natehouk/AS3310-ADSR/README.md

# SS-ADSR-1
Envelope generator based on the AS3310-ADSR.
