natehouk/AS3310-ADSR/SS-ADSR-1_BOM.xlsx

Front/Back | Manufacture | Part # | URL | Component | Description | Part | References | Value | Footprint | Quantity Per PCB | Datasheet | Field4 | Field5 | Field6
Front | ‎Vishay Beyschlag/Draloric/BC Components | ‎K103K15X7RF5TL2 | https://www.digikey.com/product-detail/en/vishay-beyschlag-draloric-bc-components/K103K15X7RF5TL2/BC1078CT-ND/286700 | 1 | Unpolarized capacitor | C | C2 C4 C5 C7 | 10nF | C_Disc_D7.5mm_W2.5mm_P5.00mm | 4 | ~
Front | NTE Electronics, Inc‎ | ‎89322 | https://www.digikey.com/product-detail/en/nte-electronics-inc/89322/2368-89322-ND/11647987 | 2 | Unpolarized capacitor | C | C1 | 22nF | C_Disc_D7.5mm_W2.5mm_P5.00mm | 1 | ~
Front | ‎Vishay Beyschlag/Draloric/BC Components | ‎K333K15X7RF5TL2 | https://www.digikey.com/product-detail/en/vishay-beyschlag-draloric-bc-components/K333K15X7RF5TL2/BC1081CT-ND/286703 | 3 | Unpolarized capacitor | C | C6 | 33nF | C_Disc_D7.5mm_W2.5mm_P5.00mm | 1 | ~
Front | ‎KEMET‎ | ‎C322C393K1R5TA | https://www.digikey.com/product-detail/en/kemet/C322C393K1R5TA/399-13949-ND/6562360 | 4 | Unpolarized capacitor | C | C3 | 39nF | C_Disc_D7.5mm_W2.5mm_P5.00mm | 1 | ~
Front | Vishay Beyschlag/Draloric/BC Components | K104Z15Y5VE5TL2 | https://www.digikey.com/en/products/detail/w%C3%BCrth-elektronik/860020572003/5728880 | 5 | Unpolarized capacitor | C | C8 C11 | .1uF | C_Disc_D7.5mm_W2.5mm_P5.00mm | 2 | ~
Front | Würth Elektronik‎ | 860020572003 | https://www.digikey.com/en/products/detail/w%C3%BCrth-elektronik/860020572003/5728880 | 6 | Polarized capacitor | C | C9 C10 | 10uF | C_Disc_D7.5mm_W2.5mm_P5.00mm | 2 | ~
Front | ‎NTE Electronics, Inc‎ | ‎1N4148 | https://www.digikey.com/product-detail/en/nte-electronics-inc/1N4148/2368-1N4148-ND/11645052 | 7 | Diode | D | D1 D2 | D | D_DO-35_SOD27_P7.62mm_Horizontal | 2 | ~
Back | Würth Elektronik‎ | ‎151051RS11000‎ | https://www.digikey.com/product-detail/en/w-rth-elektronik/151051RS11000/732-5016-ND/4490012 | 8 | Light emitting diode | LED | D3 | LED | LED_D5.0mm | 1 | ~
Front | ‎Würth Elektronik‎ | ‎61201021621‎ | https://www.digikey.com/product-detail/en/w-rth-elektronik/61201021621/732-2094-ND/2060590 | 9 |  | EURO_PWR_2x5 | J2 | EURO_PWR_2x5 | PinHeader_2x05_P2.54mm_Vertical | 1
Back | Thonkiconn | PJ398SM | https://nl.mouser.com/ProductDetail/Alpha-Taiwan/RD901F-40-15R1-B100K-00DL1?qs=1mbolxNpo8czbLgndpJJVQ%3D%3D | 10 | Audio Jack, 2 Poles (Mono / TS), Switched T Pole (Normalling) | AudioJack2_SwitchT | J1 J3 J4 | TRIGGER_IN | Jack_3.5mm_QingPu_WQP-PJ398SM_Vertical_CircularHoles | 3 | ~
Front | ON Semiconductor‎ | ‎BC548BU | https://www.digikey.com/product-detail/en/on-semiconductor/BC548BU/BC548BU-ND/976761 | 11 | 0.1A Ic, 30V Vce, Small Signal NPN Transistor, TO-92 | BC548 | Q2 | BC548 | TO-92_Inline | 1 | https://www.onsemi.com/pub/Collateral/BC550-D.pdf
Front | ‎NTE Electronics, Inc‎ | BC558‎ | https://www.digikey.com/product-detail/en/nte-electronics-inc/BC558/2368-BC558-ND/11652250 | 12 | 0.1A Ic, 30V Vce, PNP Small Signal Transistor, TO-92 | BC558 | Q1 | BC558 | TO-92_Inline | 1 | https://www.onsemi.com/pub/Collateral/BC556BTA-D.pdf
Front | Vishay Beyschlag/Draloric/BC Components‎ | ‎SFR25H0003300FR500 | https://www.digikey.com/product-detail/en/vishay-beyschlag-draloric-bc-components/SFR25H0003300FR500/56-SFR25H0003300FR500CT-ND/11507983 | 13 | Resistor | R | R26 | 330R | R_Axial_DIN0207_L6.3mm_D2.5mm_P10.16mm_Horizontal | 1 | ~
Front | Vishay Beyschlag/Draloric/BC Components‎ | ‎SFR2500004700FR500 | https://www.digikey.com/product-detail/en/vishay-beyschlag-draloric-bc-components/SFR2500004700FR500/56-SFR2500004700FR500CT-ND/11508187 | 14 | Resistor | R | R12 | 470R | R_Axial_DIN0207_L6.3mm_D2.5mm_P10.16mm_Horizontal | 1 | ~
Front | Vishay Beyschlag/Draloric/BC Components | SFR25H0001001FR500 | https://www.digikey.com/en/products/detail/vishay-beyschlag-draloric-bc-components/SFR25H0001001FR500/5065693 | 15 | Resistor | R | R5 R6 R7 R22 | 1K | R_Axial_DIN0207_L6.3mm_D2.5mm_P10.16mm_Horizontal | 4 | ~
Front | Vishay Beyschlag/Draloric/BC Components‎ | ‎SFR2500004701FR500 | https://www.digikey.com/product-detail/en/vishay-beyschlag-draloric-bc-components/SFR2500004701FR500/BC4373TR-ND/333920 | 16 | Resistor | R | R15 R23 R25 | 4K7 | R_Axial_DIN0207_L6.3mm_D2.5mm_P10.16mm_Horizontal | 3 | ~
Front | Vishay Beyschlag/Draloric/BC Components | SFR2500001002FR500 | https://www.digikey.com/en/products/detail/vishay-beyschlag-draloric-bc-components/SFR2500001002FR500/595641 | 17 | Resistor | R | R9 R16 R17 R18 R21 | 10K | R_Axial_DIN0207_L6.3mm_D2.5mm_P10.16mm_Horizontal | 5 | ~
Front | Vishay Beyschlag/Draloric/BC Components‎ | ‎SFR2500002202FR500‎ | https://www.digikey.com/product-detail/en/vishay-beyschlag-draloric-bc-components/SFR2500002202FR500/56-SFR2500002202FR500CT-ND/11508107 | 18 | Resistor | R | R11 R14 | 22K | R_Axial_DIN0207_L6.3mm_D2.5mm_P10.16mm_Horizontal | 2 | ~
Front | Vishay Beyschlag/Draloric/BC Components‎ | ‎SFR2500003602FR500‎ | https://www.digikey.com/product-detail/en/vishay-beyschlag-draloric-bc-components/SFR2500003602FR500/PPC36.0KYCT-ND/597028 | 19 | Resistor | R | R13 | 36K | R_Axial_DIN0207_L6.3mm_D2.5mm_P10.16mm_Horizontal | 1 | ~
Front | Vishay Beyschlag/Draloric/BC Components‎ | ‎SFR2500003902FR500 | https://www.digikey.com/product-detail/en/vishay-beyschlag-draloric-bc-components/SFR2500003902FR500/56-SFR2500003902FR500CT-ND/11508028 | 20 | Resistor | R | R8 | 39K | R_Axial_DIN0207_L6.3mm_D2.5mm_P10.16mm_Horizontal | 1 | ~
Front | Vishay Beyschlag/Draloric/BC Components‎ | ‎SFR2500004702FR500‎ | https://www.digikey.com/product-detail/en/vishay-beyschlag-draloric-bc-components/SFR2500004702FR500/56-SFR2500004702FR500CT-ND/11508192 | 21 | Resistor | R | R19 | 47K | R_Axial_DIN0207_L6.3mm_D2.5mm_P10.16mm_Horizontal | 1 | ~
Front | Vishay Beyschlag/Draloric/BC Components‎ | ‎MRS25000C6202FCT00 | https://www.digikey.com/product-detail/en/vishay-beyschlag-draloric-bc-components/MRS25000C6202FCT00/BC4647CT-ND/7352077 | 22 | Resistor | R | R1 R2 R3 | 62K | R_Axial_DIN0207_L6.3mm_D2.5mm_P10.16mm_Horizontal | 3 | ~
Front | Vishay Beyschlag/Draloric/BC Components | SFR16S0001003FR500 | https://www.digikey.com/en/products/detail/vishay-beyschlag-draloric-bc-components/SFR16S0001003FR500/594266 | 23 | Resistor | R | R24 | 100K | R_Axial_DIN0207_L6.3mm_D2.5mm_P10.16mm_Horizontal | 1 | ~
Front | Vishay Beyschlag/Draloric/BC Components‎ | ‎SFR2500001503FR500 | https://www.digikey.com/product-detail/en/vishay-beyschlag-draloric-bc-components/SFR2500001503FR500/PPC150KYCT-ND/596882 | 24 | Resistor | R | R20 | 150K | R_Axial_DIN0207_L6.3mm_D2.5mm_P10.16mm_Horizontal | 1 | ~
Front | Vishay Beyschlag/Draloric/BC Components‎ | ‎SFR2500004703FR500 | https://www.digikey.com/product-detail/en/vishay-beyschlag-draloric-bc-components/SFR2500004703FR500/BC4377CT-ND/7351807 | 25 | Resistor | R | R4 | 470K | R_Axial_DIN0207_L6.3mm_D2.5mm_P10.16mm_Horizontal | 1 | ~
Front | Vishay Beyschlag/Draloric/BC Components | SFR2500001004FR500 | https://www.digikey.com/en/products/detail/vishay-beyschlag-draloric-bc-components/SFR2500001004FR500/595723 | 26 | Resistor | R | R10 | 1M | R_Axial_DIN0207_L6.3mm_D2.5mm_P10.16mm_Horizontal | 1 | ~
Front | ‎Bourns Inc.‎ | ‎3266Y-1-103LF‎ | https://www.digikey.com/product-detail/en/bourns-inc/3266Y-1-103LF/3266Y-1-103LF-ND/2535458 | 27 | Trim-potentiometer | R_Potentiometer_Trim | RV5 RV6 | 10K | Potentiometer_Runtron_RM-065_Vertical | 2 | ~
Front | ‎TT Electronics/BI‎ | ‎P0915N-FC15BR50K‎ | https://www.digikey.com/product-detail/en/tt-electronics-bi/P0915N-FC15BR50K/P0915N-FC15BR50K-ND/7720803 | 28 | Potentiometer | R_Potentiometer | RV1 RV2 RV3 RV4 | 47K lin | Potentiometer_Alpha_RD901F-40-00D_Single_Vertical | 4 | ~
Back | ‎NKK Switches‎ | ‎M2044SS1W03 | https://www.digikey.com/product-detail/en/nkk-switches/M2044SS1W03/360-2865-ND/1027467 | 29 |  | M2044SS1W03 | S1 | M2044SS1W03 | SW_M2044SS1W03 | 1 | 30.9 mm | NKK Switches | 2018-05-09 | Manufacturer Recommendations
Back | E-Switch‎ | ‎PS1024ALRED | https://www.digikey.com/product-detail/en/e-switch/PS1024ALRED/EG2025-ND/81539 | 30 | Push button switch, generic, two pins | SW_Push | SW2 | SW_Push | SW_PUSH_6mm_H5mm | 1 | ~
Front | ‎Amphenol ICC (FCI)‎ | ‎DILB16P-223TLF‎ | https://www.digikey.com/product-detail/en/amphenol-icc-fci/DILB16P-223TLF/609-4713-ND/4292068 | 31 | ADSR Voltage Controlled Envelope Generator, DIP-16/SOIC-16 | AS3310 | U2 | AS3310 | DIP-16_W7.62mm | 1 | http://www.alfarzpp.lv/eng/sc/AS3310.pdf
Front | Texas Instruments‎ | ‎LM358P | https://www.digikey.com/product-detail/en/texas-instruments/LM358P/296-1395-5-ND/277042 | 32 | Low-Power, Dual Operational Amplifiers, DIP-8/SOIC-8/TO-99-8 | LM358 | U1 U3 | LM358 | DIP-8_W7.62mm | 2 | http://www.ti.com/lit/ds/symlink/lm2904-n.pdf
Front | Texas Instruments‎ | ‎LM741CN/NOPB | https://www.digikey.com/product-detail/en/texas-instruments/LM741CN-NOPB/LM741CNNS-NOPB-ND/6322 | 33 | Operational Amplifier, DIP-8/TO-99-8 | LM741 | U4 | LM741 | DIP-8_W7.62mm | 1 | http://www.ti.com/lit/ds/symlink/lm741.pdf
 | Thonk.co.uk
 | Digikey.com
 |  |  |  | Component Groups: | 33
 |  |  |  | Component Count: | 58
 |  |  |  | Fitted Components: | 58
 |  |  |  | Number of PCBs: | 1
 |  |  |  | Total components: | 58
 |  |  |  | Schematic Version: | 1
 |  |  |  | Schematic Date: | 2020-11-01
 |  |  |  | PCB Variant: | default
 |  |  |  | BoM Date: | Sun 08 Nov 2020 06:55:45 PM CET
 |  |  |  | Schematic Source: | AS3310-ADSR.sch
 |  |  |  | KiCad Version: | Eeschema 5.1.7
