natehouk/AS3310-ADSR/(list of files, drawings)

Other design files:
AS3310-ADSR.dsn
