natehouk/AS3310-ADSR/AS3310-ADSR.kicad_pcb

## KiCad design AS3310-ADSR.kicad_pcb (2020-12-31)

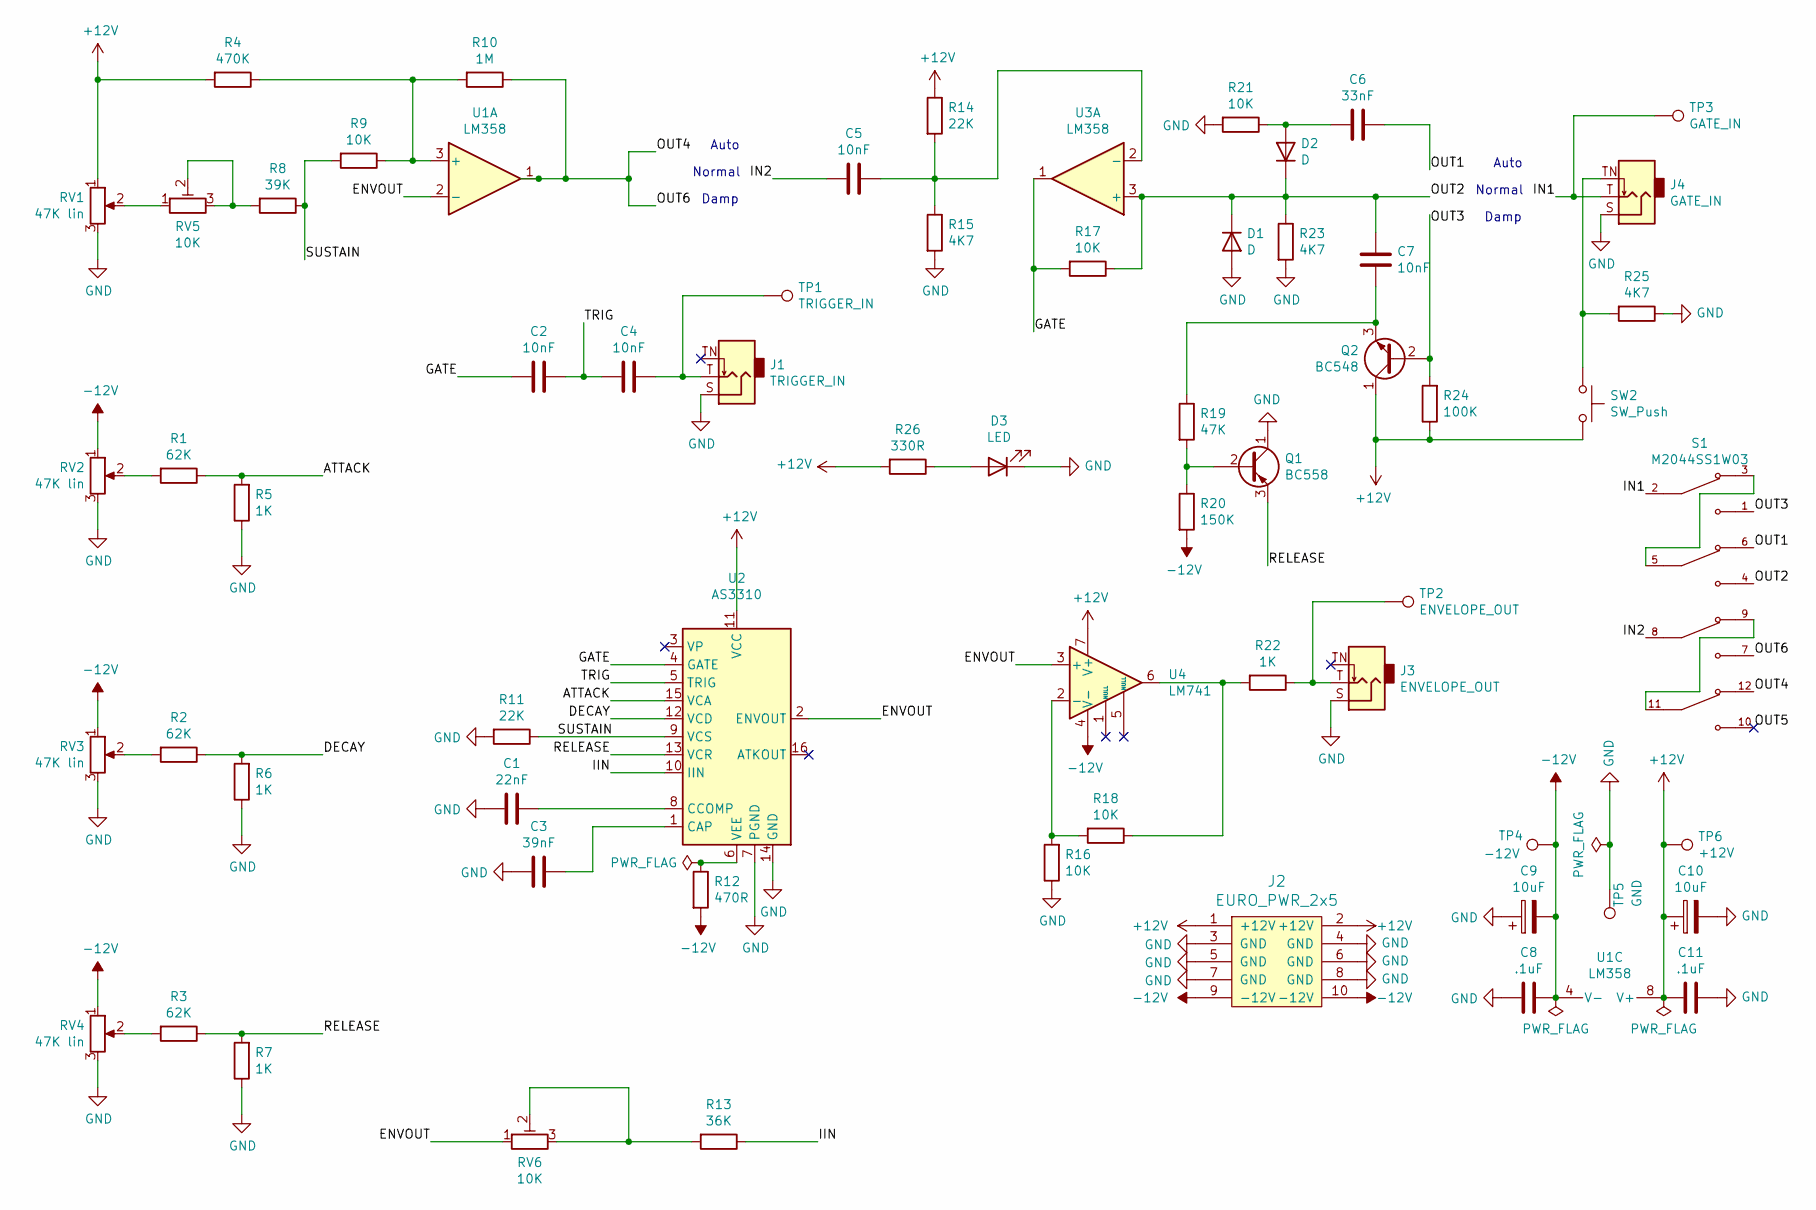
[picture p1: schematic AS3310-ADSR.sch, SS-ADSR-1]

Parts:
C1: 22nF; C_Disc_D7.5mm_W2.5mm_P5.00mm
C2, C4, C5, C7: 10nF; C_Disc_D7.5mm_W2.5mm_P5.00mm
C3: 39nF; C_Disc_D7.5mm_W2.5mm_P5.00mm
C6: 33nF; C_Disc_D7.5mm_W2.5mm_P5.00mm
C8, C11: .1uF; C_Disc_D7.5mm_W2.5mm_P5.00mm
C9, C10: 10uF; CP_Radial_D5.0mm_P2.50mm
D1, D2: D; D_DO-35_SOD27_P7.62mm_Horizontal
D3: LED; LED_D5.0mm
J1: TRIGGER_IN; Jack_3.5mm_QingPu_WQP-PJ398SM_Vertical_CircularHoles
J2: EURO_PWR_2x5; PinHeader_2x05_P2.54mm_Vertical
J3: ENVELOPE_OUT; Jack_3.5mm_QingPu_WQP-PJ398SM_Vertical_CircularHoles
J4: GATE_IN; Jack_3.5mm_QingPu_WQP-PJ398SM_Vertical_CircularHoles
Q1: BC558; TO-92_Inline
Q2: BC548; TO-92_Inline
R1, R2, R3: 62K; R_Axial_DIN0207_L6.3mm_D2.5mm_P10.16mm_Horizontal
R4: 470K; R_Axial_DIN0207_L6.3mm_D2.5mm_P10.16mm_Horizontal
R5, R6, R7, R22: 1K; R_Axial_DIN0207_L6.3mm_D2.5mm_P10.16mm_Horizontal
R8: 39K; R_Axial_DIN0207_L6.3mm_D2.5mm_P10.16mm_Horizontal
R9, R16, R17, R18, R21: 10K; R_Axial_DIN0207_L6.3mm_D2.5mm_P10.16mm_Horizontal
R10: 1M; R_Axial_DIN0207_L6.3mm_D2.5mm_P10.16mm_Horizontal
R11, R14: 22K; R_Axial_DIN0207_L6.3mm_D2.5mm_P10.16mm_Horizontal
R12: 470R; R_Axial_DIN0207_L6.3mm_D2.5mm_P10.16mm_Horizontal
R13: 36K; R_Axial_DIN0207_L6.3mm_D2.5mm_P10.16mm_Horizontal
R15, R23, R25: 4K7; R_Axial_DIN0207_L6.3mm_D2.5mm_P10.16mm_Horizontal
R19: 47K; R_Axial_DIN0207_L6.3mm_D2.5mm_P10.16mm_Horizontal
R20: 150K; R_Axial_DIN0207_L6.3mm_D2.5mm_P10.16mm_Horizontal
R24: 100K; R_Axial_DIN0207_L6.3mm_D2.5mm_P10.16mm_Horizontal
R26: 330R; R_Axial_DIN0207_L6.3mm_D2.5mm_P10.16mm_Horizontal
RV1, RV2, RV3, RV4: 47K lin; Potentiometer_Alpha_RD901F-40-00D_Single_Vertical
RV5, RV6: 10K; TRIM_3266W-1-102LF
S1: M2044SS1W03; SW_M2044SS1W03
SW2: SW_Push; SW_PS1024ALRED
TP1: TRIGGER_IN; TestPoint_Pad_4.0x4.0mm
TP2: ENVELOPE_OUT; TestPoint_Pad_4.0x4.0mm
TP3: GATE_IN; TestPoint_Pad_4.0x4.0mm
TP4: -12V; TestPoint_Pad_4.0x4.0mm
TP5: GND; TestPoint_Pad_4.0x4.0mm
TP6: +12V; TestPoint_Pad_4.0x4.0mm
U1, U3: LM358; DIP-8_W7.62mm
U2: AS3310; DIP-16_W7.62mm
U4: LM741; DIP-8_W7.62mm

Connections:
+12V: C10.1, C11.2, J2.1 (+12V), J2.2 (+12V), Q2.1 (C), R4.2, R14.1, R24.1, R26.2, RV1.1, SW2.2, TP6.1, U1.8 (V+), U2.11 (VCC), U4.7 (V+)
-12V: C8.1, C9.2, J2.9 (-12V), J2.10 (-12V), R12.2, R20.2, RV2.1, RV3.1, RV4.1, TP4.1, U1.4 (V-), U4.4 (V-)
/ATTACK: R1.1, R5.2, U2.15 (VCA)
/DECAY: R2.1, R6.2, U2.12 (VCD)
/ENVOUT: RV6.1, U1.2 (-), U2.2 (ENVOUT), U4.3 (+)
/GATE: C2.2, R17.2, U2.4 (GATE), U3.1
/IIN: R13.1, U2.10 (IIN)
/IN1: J4.T, S1.2, TP3.1
/IN2: C5.2, S1.8
/OUT1: C6.1, S1.6
/OUT2: C7.1, D1.1 (K), D2.1 (K), R17.1, R23.1, S1.4, U3.3 (+)
/OUT3: Q2.2 (B), R24.2, S1.1
/OUT4: R10.1, S1.7, S1.12, U1.1
/RELEASE: Q1.3 (E), R3.1, R7.2, U2.13 (VCR)
/SUSTAIN: R8.1, R9.2, R11.1, U2.9 (VCS)
/TRIG: C2.1, C4.2, U2.5 (TRIG)
GND: C1.2, C3.2, C8.2, C9.1, C10.2, C11.1, D1.2 (A), D3.1 (K), J1.S, J2.3 (GND), J2.4 (GND), J2.5 (GND), J2.6 (GND), J2.7 (GND), J2.8 (GND), J3.S, J4.S, Q1.1 (C), R5.1, R6.1, R7.1, R11.2, R15.2, R16.1, R21.2, R23.2, R25.1, RV1.3, RV2.3, RV3.3, RV4.3, TP5.1, U2.7 (PGND), U2.14 (GND)
unnamed: C1.1, U2.8 (CCOMP)
unnamed: C3.1, U2.1 (CAP)
unnamed: C4.1, J1.T, TP1.1
unnamed: C5.1, R14.2, R15.1, U3.2 (-)
unnamed: C6.2, D2.2 (A), R21.1
unnamed: C7.2, Q2.3 (E), R19.1
unnamed: D3.2 (A), R26.1
unnamed: J3.T, R22.1, TP2.1
unnamed: J4.TN, R25.2, SW2.1
unnamed: Q1.2 (B), R19.2, R20.1
unnamed: R1.2, RV2.2
unnamed: R2.2, RV3.2
unnamed: R3.2, RV4.2
unnamed: R8.2, RV5.2, RV5.3
unnamed: R4.1, R9.1, R10.2, U1.3 (+)
unnamed: R12.1, U2.6 (VEE)
unnamed: R13.2, RV6.2, RV6.3
unnamed: R16.2, R18.2, U4.2 (-)
unnamed: R18.1, R22.2, U4.6
unnamed: RV1.2, RV5.1
unnamed: S1.3, S1.5
unnamed: S1.9, S1.11

Notes on the sheet:
Auto
Normal
Damp

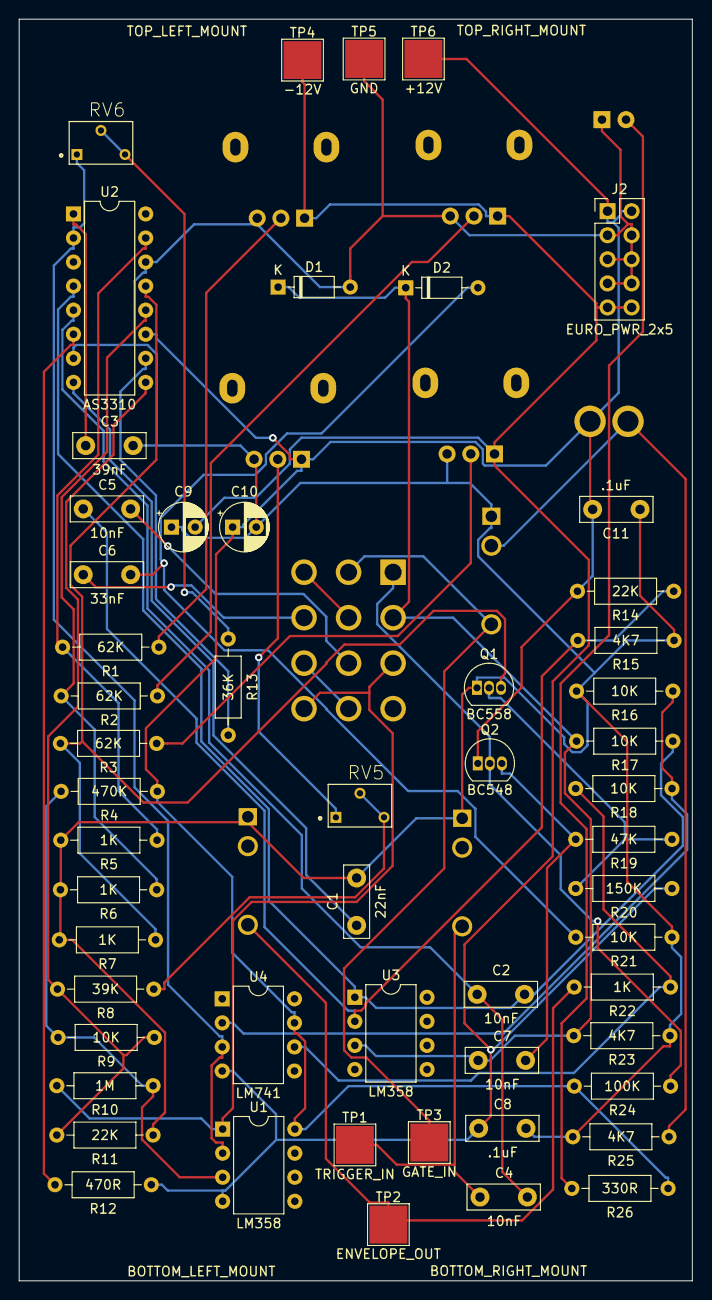
[picture p2: board AS3310-ADSR.kicad_pcb from above]

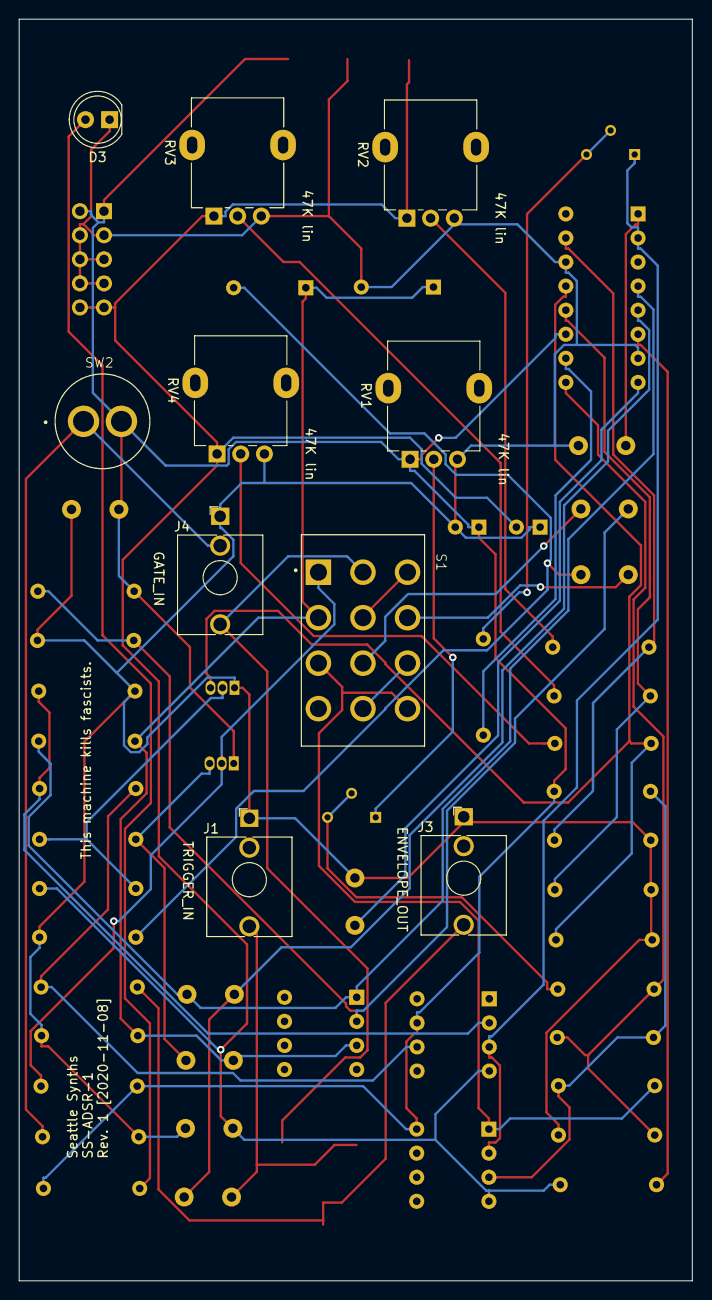
[picture p3: board AS3310-ADSR.kicad_pcb from below]

Board: 2 copper layers, 71.0 x 133.1 mm, 68 parts (10 on the bottom side), 39 nets.

Other parts of the board:
BOTTOM_LEFT_MOUNT: MountingHole_3.2mm_M3_Oval
BOTTOM_RIGHT_MOUNT: MountingHole_3.2mm_M3_Oval
TOP_LEFT_MOUNT: MountingHole_3.2mm_M3_Oval
TOP_RIGHT_MOUNT: MountingHole_3.2mm_M3_Oval
