natehouk/AS3310-ADSR/(commit log)

2020-11-01 Fix typo.
    [AS3310-ADSR.kicad_pcb, AS3310-ADSR.sch, AS3310-ASDR.sch]
2020-11-02 Add Eurocad symbols and footprints.
    [AS3310-ADSR.sch]
2020-11-03 Refactor DP3T switch.
    [AS3310-ADSR.kicad_pcb, AS3310-ADSR.sch]
